nickrunner/ACR/Clock_Radio_Project/Requirements/Block Diagram.pdf

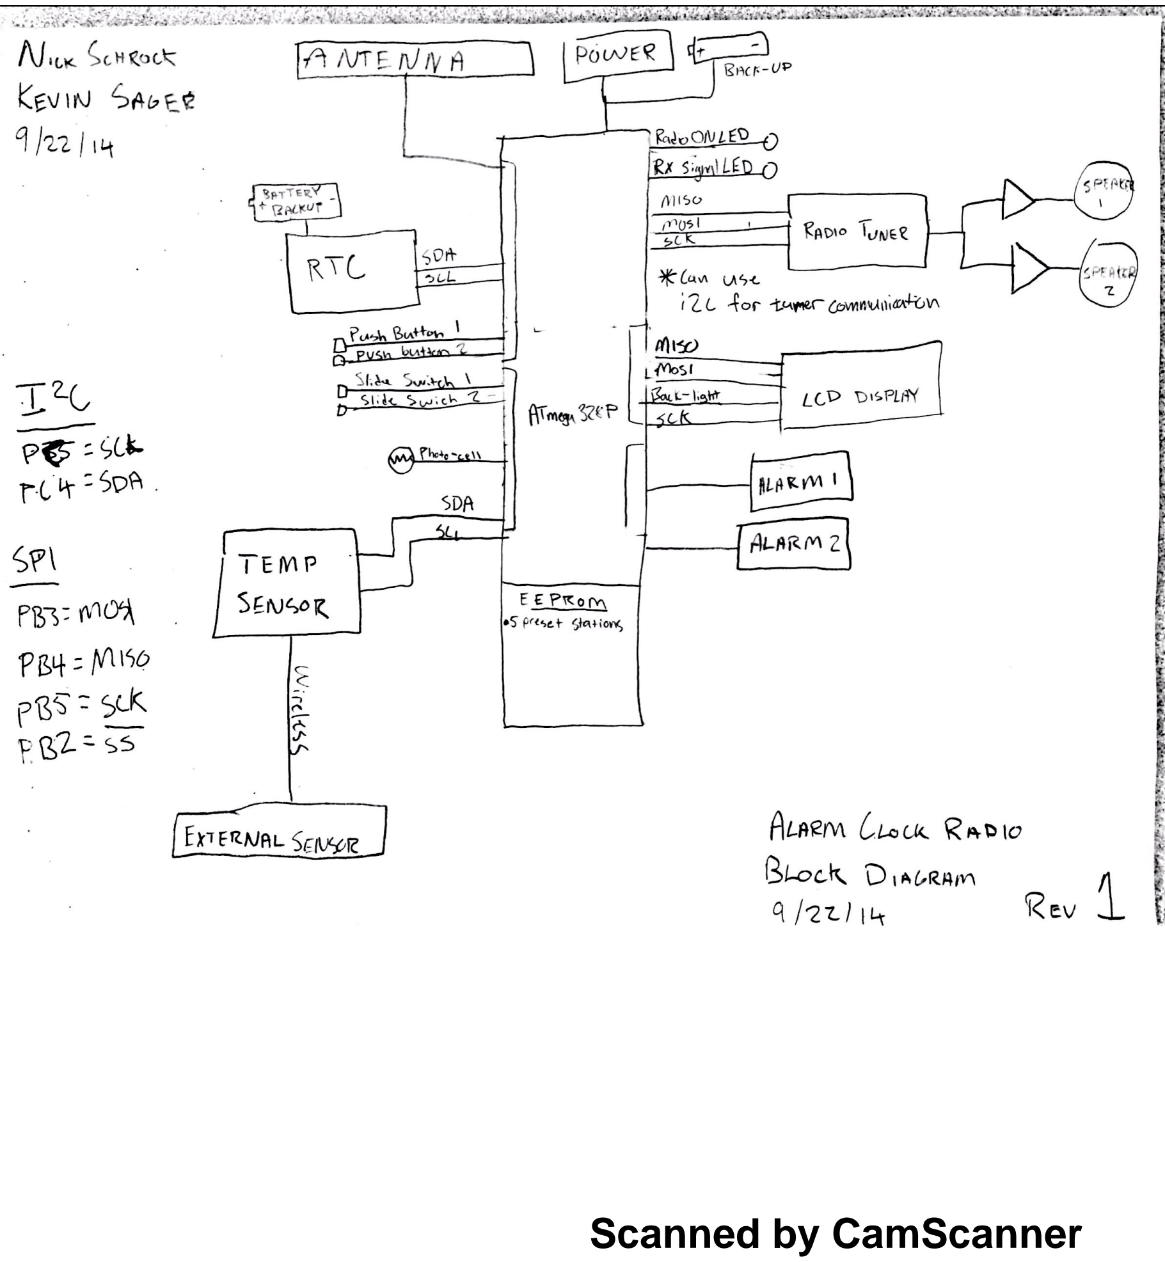
[picture p36: page 1]

# Scanned by CamScanner

/ I

艮
R • • 1

H
n A / R L S m v E
$L RP M | La 乙欠 | R | w

g

1 h. 2 /
t Lt
; 9 ; | -
究步苎立ヨ | ー | 。
;2 9 o r | m *
1re F | D v & n U \ l : a c
| | B
o | w

L

g W 9 D !1

_ | J

Ec r
, | u | p

q f
