nickrunner/ACR/Clock_Radio_Project/Requirements/Required Parts.pdf

Parts for Project Prototyping

One of each of the following parts has been ordered for each team. Replacement parts for those damaged during the prototyping process can be replaced at the following sites:

1. Silicon Instruments si4703 FM tuner breakout board http://store.linksprite.com/breakoutboard-for-si4703-fm-tuner/ (http://store.linksprite.com/breakout-board-for-si4703-fm-tuner/)
2. DS1307 Real Time Clock breakout board http://www.adafruit.com/product/264
3. Nokia 5110 graphic LCD https://www.sparkfun.com/products/10168
